escaleraalcielo/sediment_ctrl_234/Programa Windows/Codigo Fuente/SedimentTrapSoftware/AlarmaArduino/img/IMG_20160612_194149089_HDR.jpg

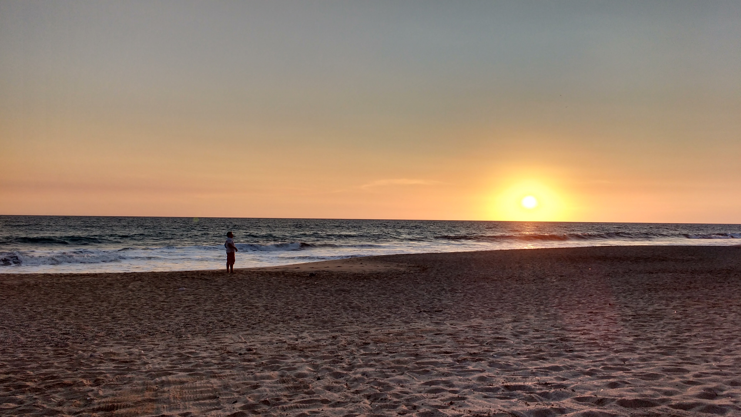
Programa Windows/Codigo Fuente/SedimentTrapSoftware/AlarmaArduino/img/IMG_20160612_194149089_HDR.jpg
