escaleraalcielo/sediment_ctrl_234/Programa Windows/Codigo Fuente/SedimentTrapSoftware/AlarmaArduino/img/Capture.PNG

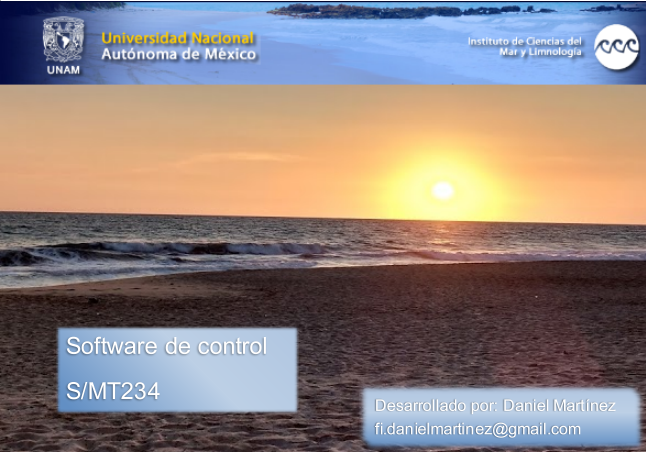
Programa Windows/Codigo Fuente/SedimentTrapSoftware/AlarmaArduino/img/Capture.PNG
