escaleraalcielo/sediment_ctrl_234/README.md

# sediment_ctrl_234
 Repositorio en Github con todo el contenido relacionado con el rediseño de la trampa de sediemntos S/MT 234
