escaleraalcielo/sediment_ctrl_234/PCB Diseño/Eagle/Circuito de Control/Sediment Board single.html

Partlist exported from C:/Users/Daniel/Documents/eagle/Sediment_Trap_Sept_2016/Sediment Board single.sch at 06/09/2016 05:12 p.m.

Part | Value | Device | Package | Description | MF | MPN | OC_FARNELL | OC_NEWARK | PROD_ID
BAT1 | CR2032 | BATTERY20PTH | BATTCOM_20MM_PTH | Battery Holders
C1 | 22pF | CNP-C025-050X025 | C025-050X025 | NON-POLARIZED CAP
C2 | 22pF | CNP-C025-050X025 | C025-050X025 | NON-POLARIZED CAP
C3 | 100nF | CNP-C025-050X025 | C025-050X025 | NON-POLARIZED CAP
C4 | 100nF | CNP-C025-050X025 | C025-050X025 | NON-POLARIZED CAP
C5 | 0.33uF | CP-TT025-040 | TT-025-040 | POLARIZED CAP
C6 | 1uF | CP-TT025-040 | TT-025-040 | POLARIZED CAP
C7 | 22uF | CNP-C025-050X025 | C025-050X025 | NON-POLARIZED CAP
D1 | 1N4004 | 1N4004 | DO41-10 | DIODE
D2 | 1N4004 | 1N4004 | DO41-10 | DIODE
D3 | 1N4947 | 1N4942 | DO41-10 | DIODE
D4 | 1N4947 | 1N4942 | DO41-10 | DIODE
D5 | 1N4947 | 1N4942 | DO41-10 | DIODE
D6 | 1N4947 | 1N4942 | DO41-10 | DIODE
D7 | 1N4004 | 1N4004 | DO41-10 | DIODE
IC1 | PCF8583P | PCF8583P | DIL08 | I2C-Bus CLOCK/CALENDAR
IC2 | ATMEGA328P | ATMEGA328PROUND | DIL28-3-ROUND | MICROCONTROLLER
J1 | Motor | M023.5MM | SCREWTERMINAL-3.5MM-2 | Standard 2-pin 0.1" header. Use with | | | | | CONN-08399
J2 | VH_Batt | M023.5MM | SCREWTERMINAL-3.5MM-2 | Standard 2-pin 0.1" header. Use with | | | | | CONN-08399
J3 | DB9_Fem | DB9FEMALE | DB9 | DB9 Connector | | | | | CONN-08194
JP1 | AVR-ISP-6 | AVR-ISP-6 | AVR-ISP-6 | AVR ISP-6 Serial Programming Header
JP3 | ENCODER | M03POLAR | MOLEX-1X3 | Header 3
MC7805CTG | +5V | V_REG_78XXSIDE | 78XXL | Voltage Regulator
Q1 | 32.768kHz | CRYSTALTC26H | TC26H | CRYSTAL | | | unknown | unknown
Q2 | 16MHz | CRYSTALHC49U70 | HC49U70 | CRYSTAL | | | unknown | unknown
R1 | 10k | R-US_0207/10 | 0207/10 | RESISTOR, American symbol
R2 | 10k | R-US_0207/10 | 0207/10 | RESISTOR, American symbol
R3 | 10k | R-US_0207/10 | 0207/10 | RESISTOR, American symbol
S1 | SW-2PTH | SWITCH-MOMENTARY-2PTH | TACTILE-PTH
U1 | L298 | L298 | MULTIWATT15 | L298 Dual Full Bridge Driver
