escaleraalcielo/sediment_ctrl_234/PCB Diseño/Eagle/Circuito de Control/GERBER/Top Silkscreen.pdf

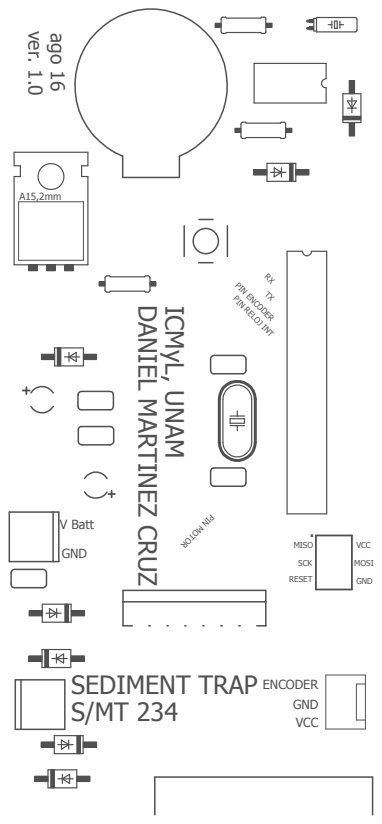
[picture p3: figure]
GND; V Batt; PIN E P NCODER IN RELOJ INT; GND VCC; ENCODER; VCC; MOSI; MISO; SCK; RESET; PIN MOTOR; SEDIMENT TRAP S/MT 234; DANIEL MARTINEZ CRUZ; ICMyL, UNAM; ver. 1.0; ago 16
