escaleraalcielo/sediment_ctrl_234/PCB Diseño/Eagle/RS233/RS233.png

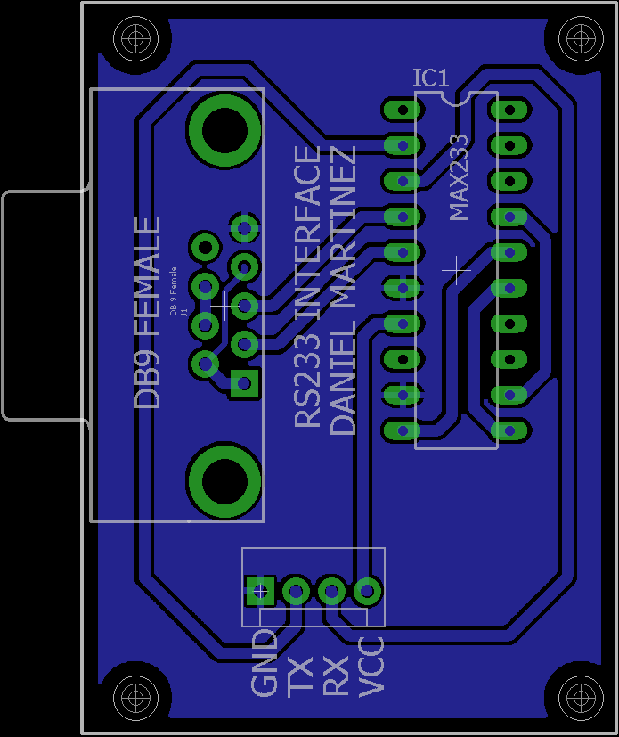
PCB Diseño/Eagle/RS233/RS233.png
