escaleraalcielo/sediment_ctrl_234/PCB Diseño/Eagle/RS233/Sediment_trap (1).png

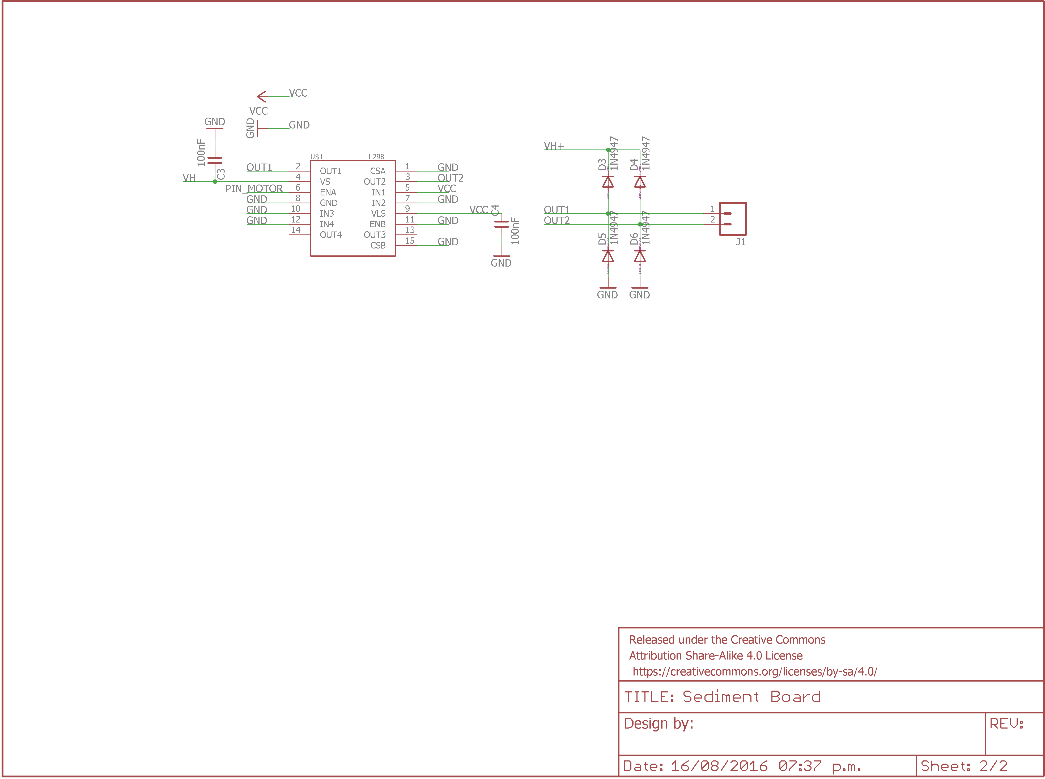
PCB Diseño/Eagle/RS233/Sediment_trap (1).png
