escaleraalcielo/sediment_ctrl_234/Programa Windows/Codigo Fuente/SedimentTrapSoftware/AlarmaArduino/img/icml.png

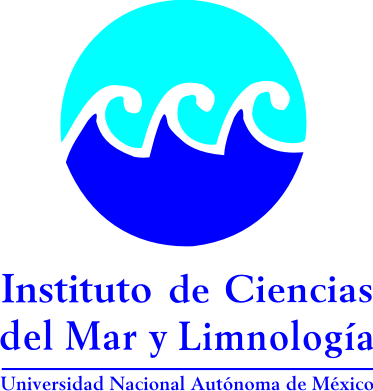
Programa Windows/Codigo Fuente/SedimentTrapSoftware/AlarmaArduino/img/icml.png
