escaleraalcielo/sediment_ctrl_234/PCB Diseño/Eagle/Circuito de Control/BOM.docx

Part | Value | Device
BAT1 | - | Base para batería
BAT1 | CR2032 | Batería CR2032
C1 | 22pF | Capacitor cerámico
C2 | 22pF | Capacitor cerámico
C3 | 100nF | Capacitor cerámico
C4 | 100nF | Capacitor cerámico
C5 | 0.33uF | Capacitor de tantalio
C6 | 1uF | Capacitor de tantalio
C7 | 22uF | Capacitor de tantalio
D1 | 1N4004 | Diodo 1N4004
D2 | 1N4004 | Diodo 1N4004
D3 | 1N4947 | Diodo recuperación rápida
D4 | 1N4947 | Diodo recuperación rápida
D5 | 1N4947 | Diodo recuperación rápida
D6 | 1N4947 | Diodo recuperación rápida
D7 | 1N4004 | Diodo 1N4004
IC1 | PCF8583P | RTC PCF8583P
IC2 | ATMEGA328P
J1 | MOLEX2 | Conector MOLEX 2 pines
J2 | MOLEX2 | Conector MOLEX 2 pines
J3 | DB9_Fem | Conector DB9 Hembra
JP1 | AVR-ISP-6 | Jumper 2 x 3
JP3 | MOLEX3 | Conector MOLEX 3 pines
MC7805CTG | +5V | Regulador de 5V
Q1 | 32.768kHz | CRISTAL 32.768kHz
Q2 | 16MHz | CRISTAL 16MHz
R1 | 10k | Resistencia
R2 | 10k | Resistencia
R3 | 10k | Resistencia
S1 | SW-2PTH | Push Button-2PTH
U1 | L298 | L298
