escaleraalcielo/sediment_ctrl_234/Programa Windows/Codigo Fuente/SedimentTrapSoftware/AlarmaArduino/bin/Debug/test.txt

Fechas de control de la trampa de sedimentos

Instituto de Ciencias del Mar y Limnologia, UNAM

Fecha de creacion del archivo: 
30/08/2016 04:34:57 p.m.

Lista de fechas programadas en la trampa de sedimentos
1) 01/09/2016
2) 15/09/2016
3) 01/10/2016
