escaleraalcielo/sediment_ctrl_234/PCB Diseño/Eagle/RS233/RS233_BRD.pdf

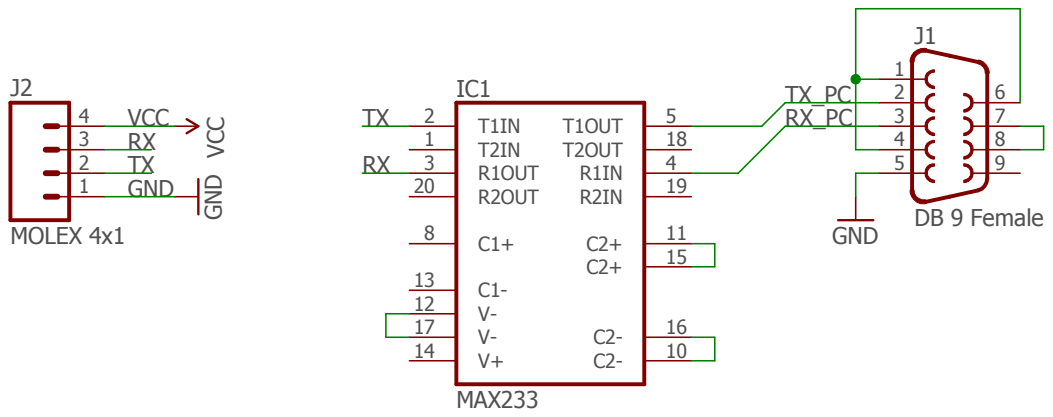
[picture p9: page 1]
MAX233; DB 9 Female; MOLEX 4x1; VCC GND; GND; T1IN 2 T2IN 1 R1OUT 3 R2OUT 20; T1OUT; T2OUT; VCC; Design by:

Released under the Creative Commons
Attribution Share-Alike 4.0 License
https://creativecommons.org/licenses/by-sa/4.0/

11/08/2016 09:38 p.m. C:\Users\Daniel\Documents\eagle\RS233\RS233_BRD.sch (Sheet: 1/1)
