escaleraalcielo/sediment_ctrl_234/PCB Diseño/Eagle/RS233/RS233_BRD_PCB.pdf

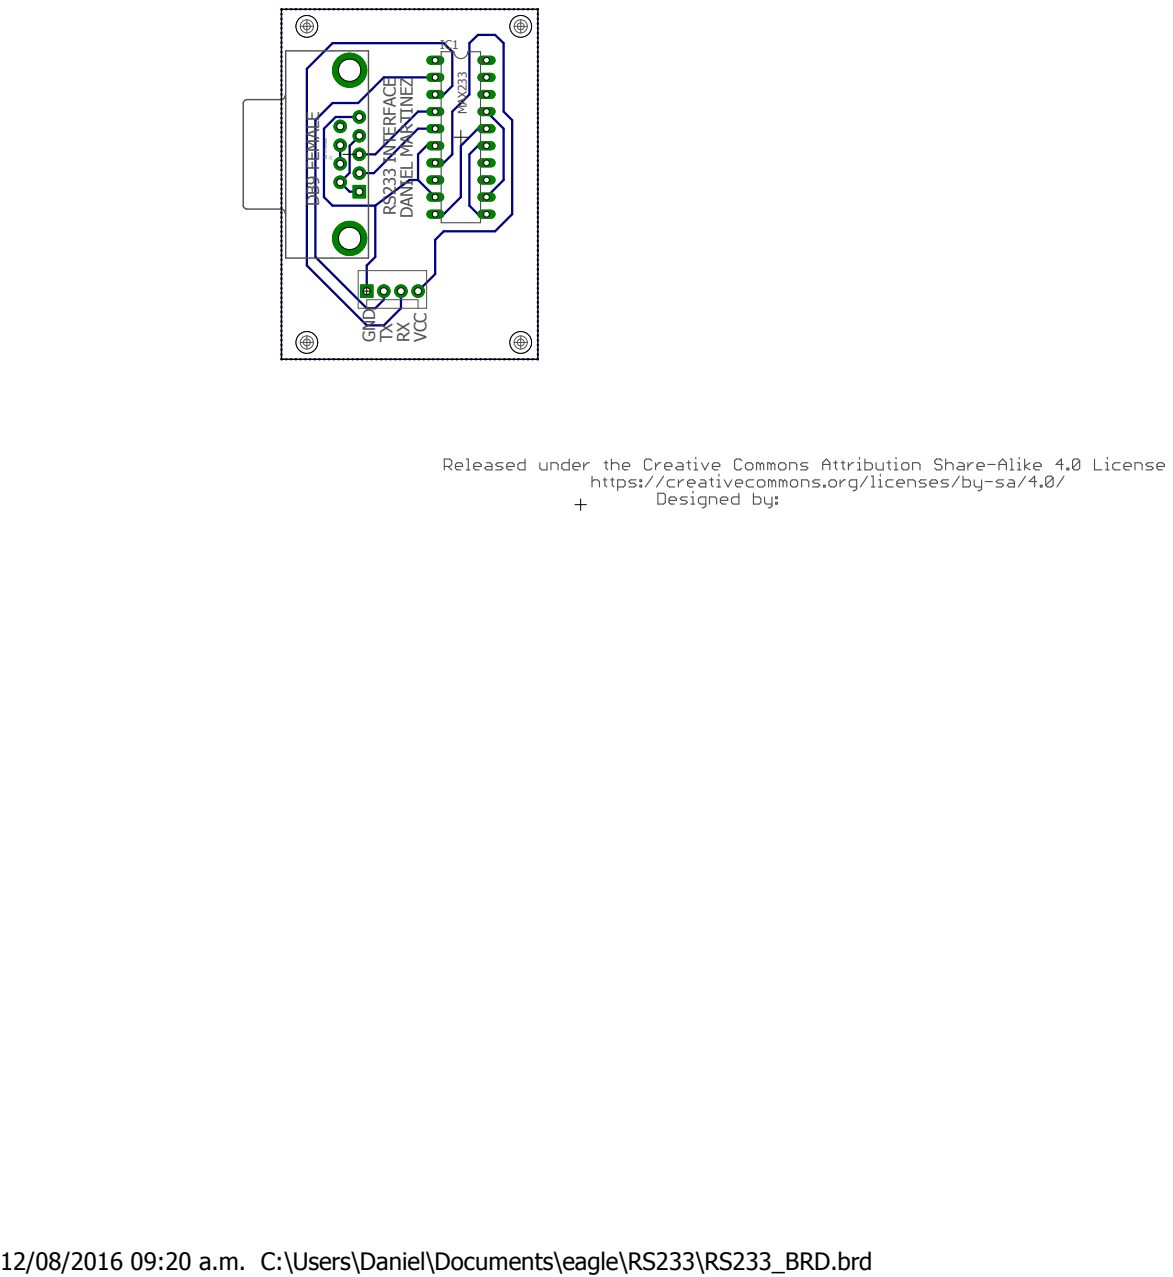
[picture p10: page 1]
12/08/2016 09:20 a.m. C:\Users\Daniel\Documents\eagle\RS233\RS233_BRD.brd GND TXRXVCC DB9 FEMALE; RS233 INTERFACE DANIEL MARTINEZ; MAX233; DB 9 Female
