escaleraalcielo/sediment_ctrl_234/PCB Diseño/Eagle/Circuito de Control/GERBER/Bottom Copper.pdf

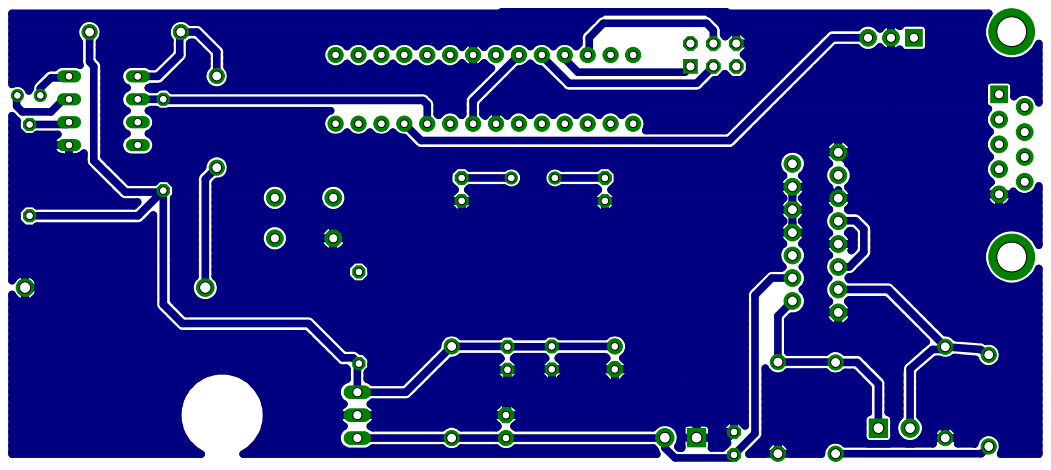
[picture p11: page 1]
