escaleraalcielo/sediment_ctrl_234/PCB Diseño/Eagle/Circuito de Control/GERBER/bottom soldermask.pdf

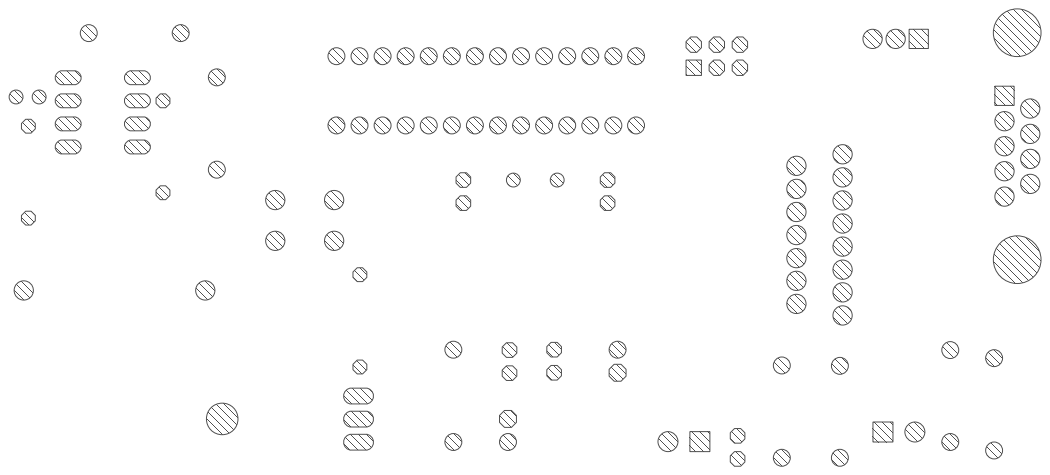
[picture p12: page 1]
