escaleraalcielo/sediment_ctrl_234/PCB Diseño/Eagle/Circuito de Control/GERBER/Drill File.pdf

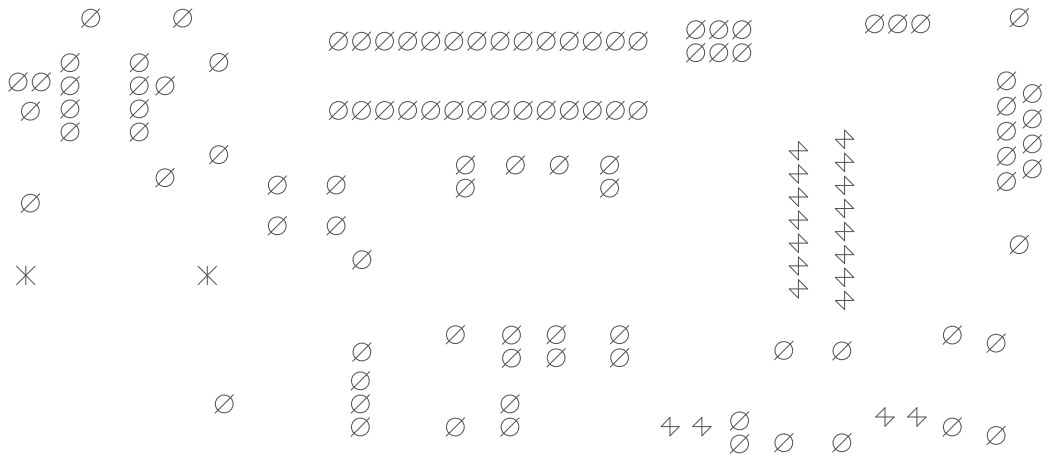
[picture p13: page 1]
