escaleraalcielo/sediment_ctrl_234/PCB Diseño/Eagle/Circuito de Control/GERBER/Top Copper.pdf

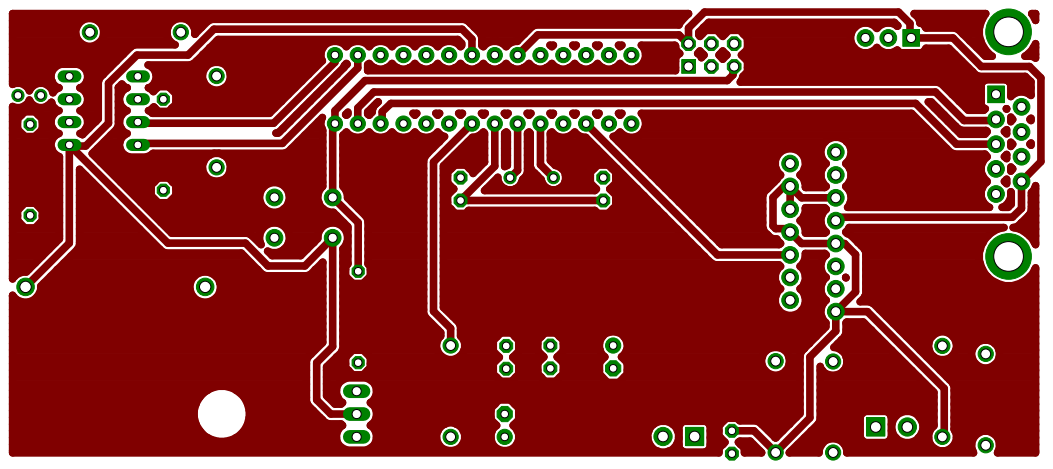
[picture p14: page 1]
