escaleraalcielo/sediment_ctrl_234/PCB Diseño/Eagle/Circuito de Control/GERBER/top soldermask.pdf

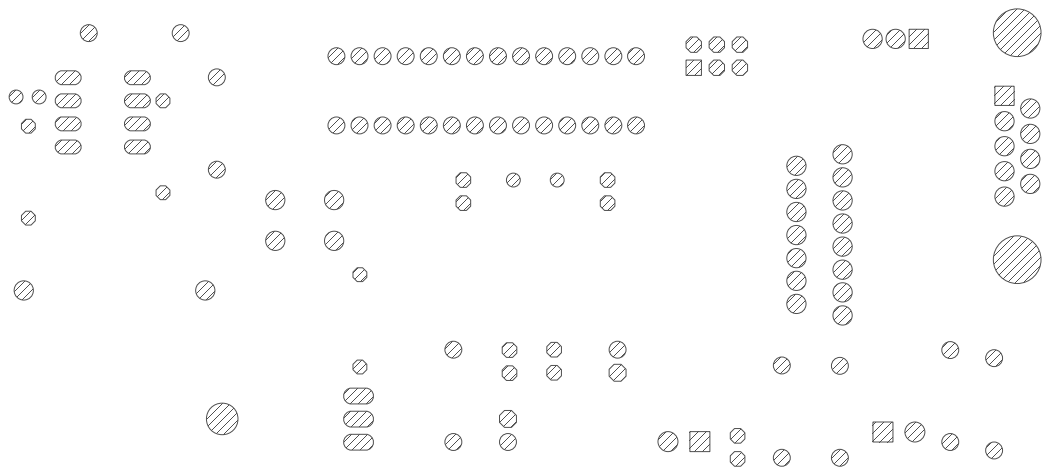
[picture p15: page 1]
