escaleraalcielo/sediment_ctrl_234/PCB Diseño/Eagle/Circuito de Control/Sediment Board.brd

## EAGLE design PCB Diseño/Eagle/Circuito de Control/Sediment Board.brd (2016-09-06)

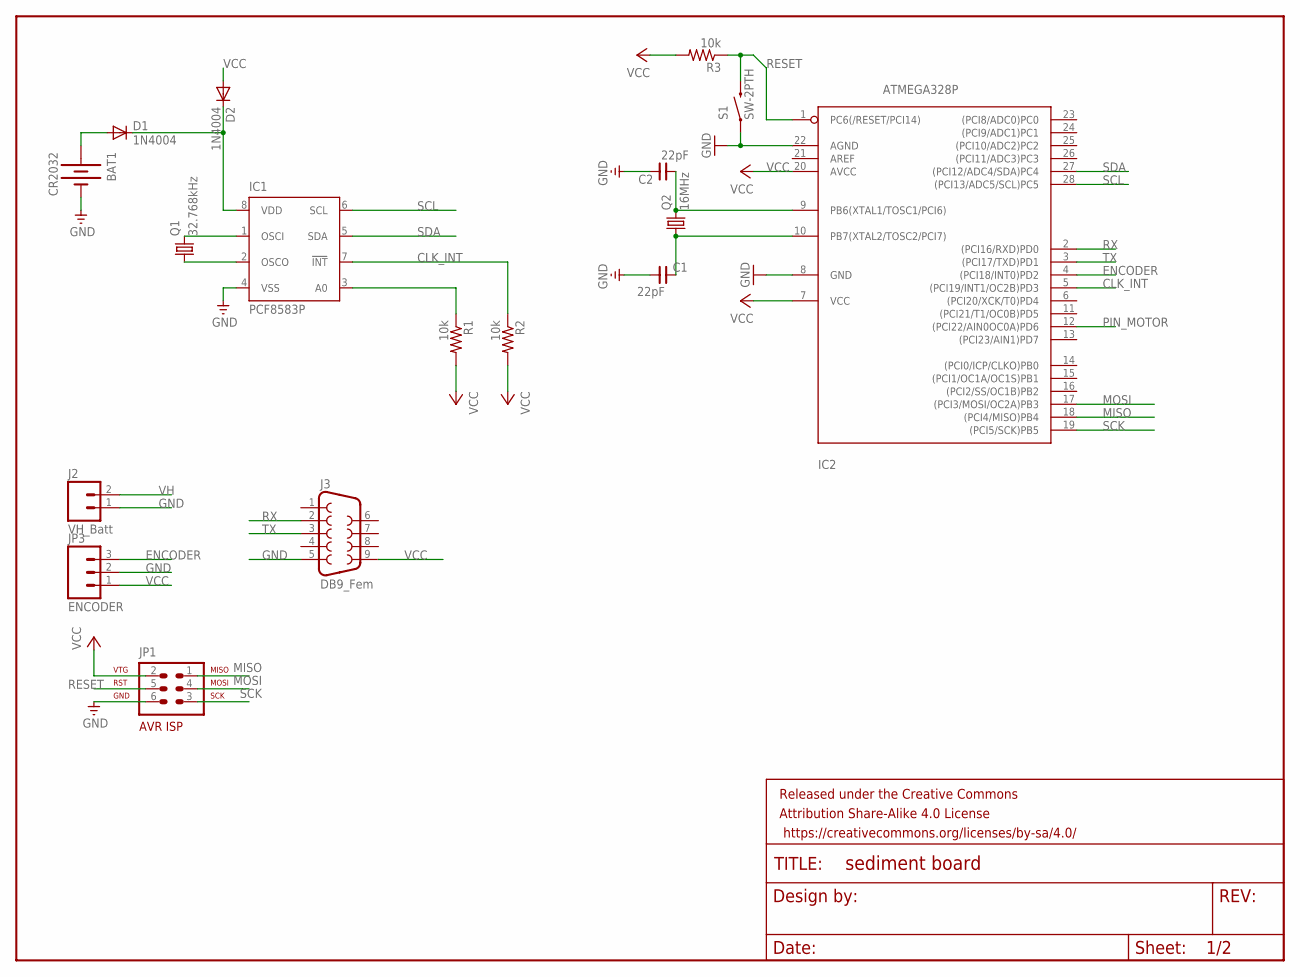
[picture p16: schematic Sediment Board.sch, sheet 1]

Parts:
BAT1: CR2032; BATTCOM_20MM_PTH
C1, C2: 22pF; C025-050X025
D1, D2: 1N4004; DO41-10
FRAME1: FRAME-LETTER; CREATIVE_COMMONS
IC1: PCF8583P; DIL08
IC2: ATMEGA328P; DIL28-3-ROUND
J2: VH_Batt; SCREWTERMINAL-3.5MM-2
J3: DB9_Fem; DB9
JP1: AVR-ISP-6
JP3: ENCODER; MOLEX-1X3
Q1: 32.768kHz; TC26H
Q2: 16MHz; HC49U70
R1, R2, R3: 10k; 0207/10
S1: SW-2PTH; TACTILE-PTH

Connections:
CLK_INT: IC1.7 (!INT), IC2.5 ((PCI19/INT1/OC2B)PD3), R2.1
ENCODER: IC2.4 ((PCI18/INT0)PD2), JP3.3
GND: BAT1.2 (-), C1.1, C2.2, IC1.4 (VSS), IC2.8 (GND), IC2.22 (AGND), J2.1, J3.5, JP1.6, JP3.2, S1.1; also elsewhere on the board
MISO: IC2.18 ((PCI4/MISO)PB4), JP1.1
MOSI: IC2.17 ((PCI3/MOSI/OC2A)PB3), JP1.4
unnamed: D1.C, D2.C, IC1.8 (VDD)
unnamed: IC1.1 (OSCI), Q1.2
unnamed: IC1.2 (OSCO), Q1.1
unnamed: BAT1.1 (+), D1.A
unnamed: IC1.3 (A0), R1.1
unnamed: C2.1, IC2.9 (PB6(XTAL1/TOSC1/PCI6)), Q2.2
unnamed: C1.2, IC2.10 (PB7(XTAL2/TOSC2/PCI7)), Q2.1
PIN_MOTOR: IC2.12 ((PCI22/AIN0OC0A)PD6); also elsewhere on the board
RESET: IC2.1 (PC6(/RESET/PCI14)), JP1.5, R3.1, S1.3 (2)
RX: IC2.2 ((PCI16/RXD)PD0), J3.2
SCK: IC2.19 ((PCI5/SCK)PB5), JP1.3
SCL: IC1.6 (SCL), IC2.28 ((PCI13/ADC5/SCL)PC5)
SDA: IC1.5 (SDA), IC2.27 ((PCI12/ADC4/SDA)PC4)
TX: IC2.3 ((PCI17/TXD)PD1), J3.3
VCC: D2.A, IC2.7 (VCC), IC2.20 (AVCC), J3.9, JP1.2, JP3.1, R1.2, R2.2, R3.2; also elsewhere on the board
VH: J2.2; also elsewhere on the board

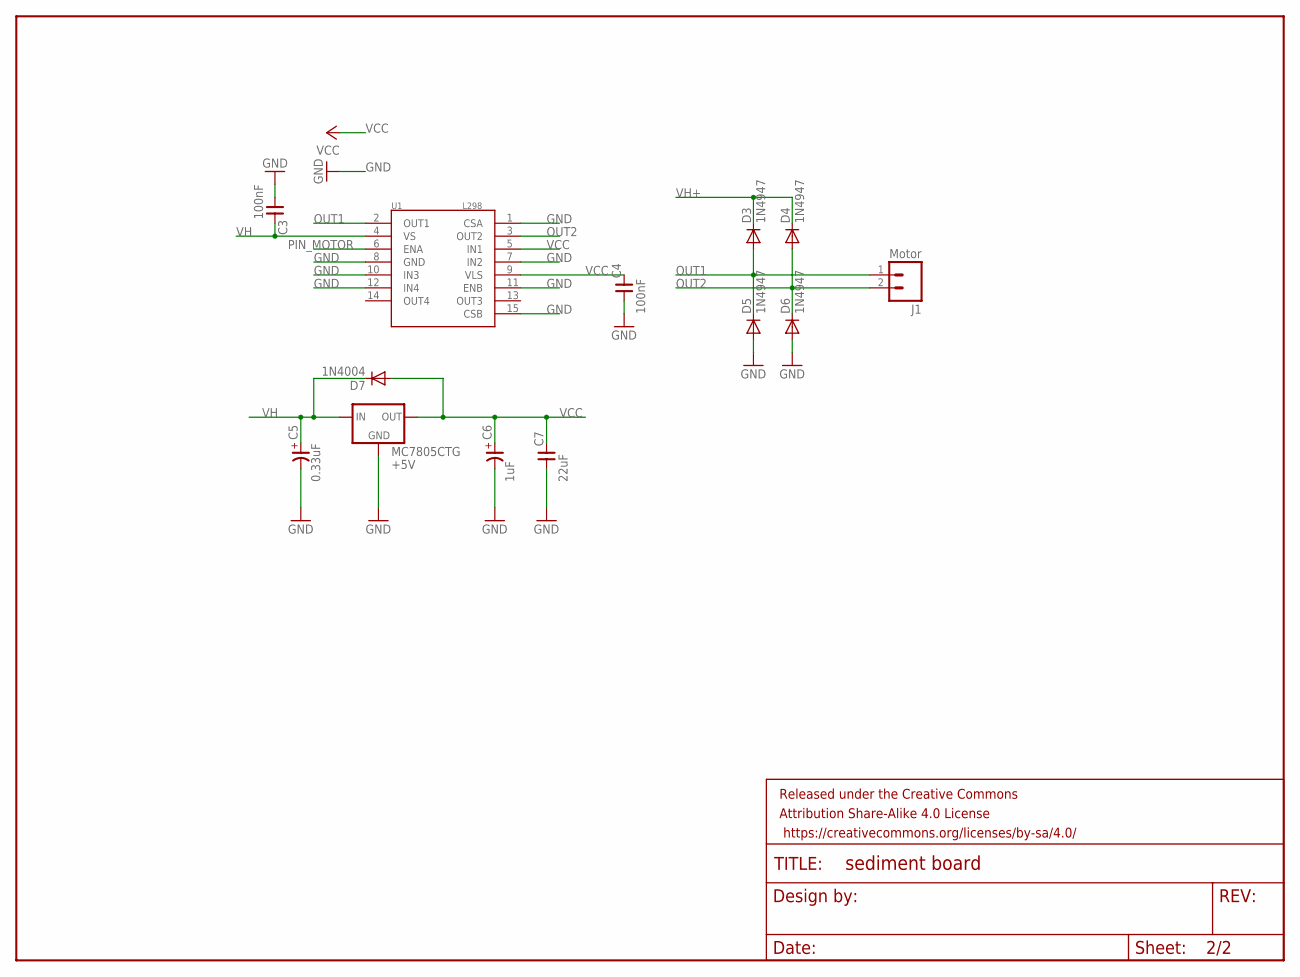
[picture p17: schematic Sediment Board.sch, sheet 2]

Parts:
C3, C4: 100nF; C025-050X025
C5: 0.33uF; TT-025-040
C6: 1uF; TT-025-040
C7: 22uF; C025-050X025
D3, D4, D5, D6: 1N4947; DO41-10
D7: 1N4004; DO41-10
FRAME2: FRAME-LETTER; CREATIVE_COMMONS
J1: Motor; SCREWTERMINAL-3.5MM-2
MC7805CTG: +5V; 78XXL
U1: L298; MULTIWATT15

Connections:
GND: C3.1, C4.1, C5.-, C6.-, C7.1, D5.A, D6.A, MC7805CTG.GND, U1.1 (CSA), U1.7 (IN2), U1.8 (GND), U1.10 (IN3), U1.11 (ENB), U1.12 (IN4), U1.15 (CSB); also elsewhere on the board
OUT1: D3.A, D5.C, J1.1, U1.2 (OUT1)
OUT2: D4.A, D6.C, J1.2, U1.3 (OUT2)
PIN_MOTOR: U1.6 (ENA); also elsewhere on the board
VCC: C4.2, C6.+, C7.2, D7.A, MC7805CTG.OUT, U1.5 (IN1), U1.9 (VLS); also elsewhere on the board
VH: C3.2, C5.+, D7.C, MC7805CTG.IN, U1.4 (VS); also elsewhere on the board
VH+: D3.C, D4.C

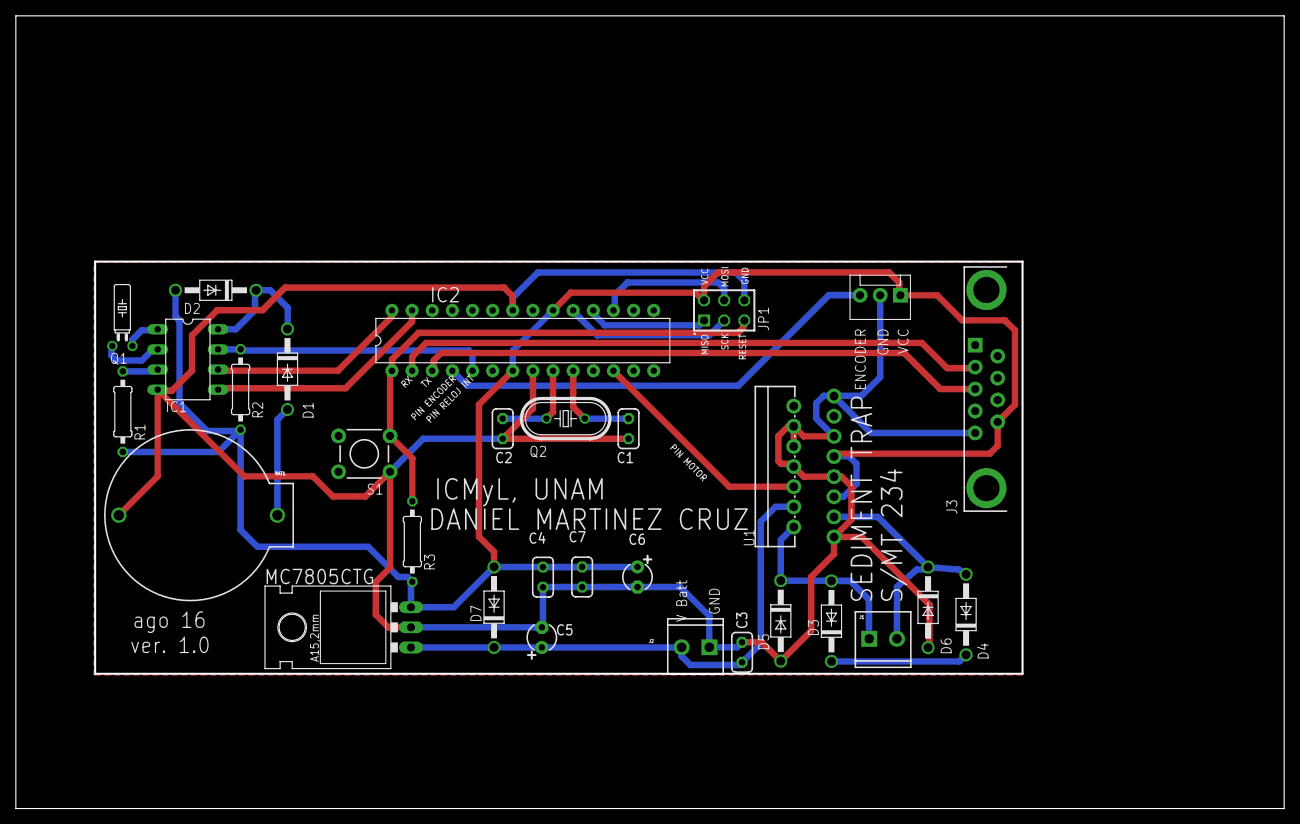
[picture p18: board Sediment Board.brd from above]

Board: 2 copper layers, 160.0 x 100.0 mm, 32 parts (0 on the bottom side), 24 nets.
