escaleraalcielo/sediment_ctrl_234/PCB Diseño/Eagle/RS233/RS233_BRD_single.brd

## EAGLE design PCB Diseño/Eagle/RS233/RS233_BRD_single.brd (2016-09-06)

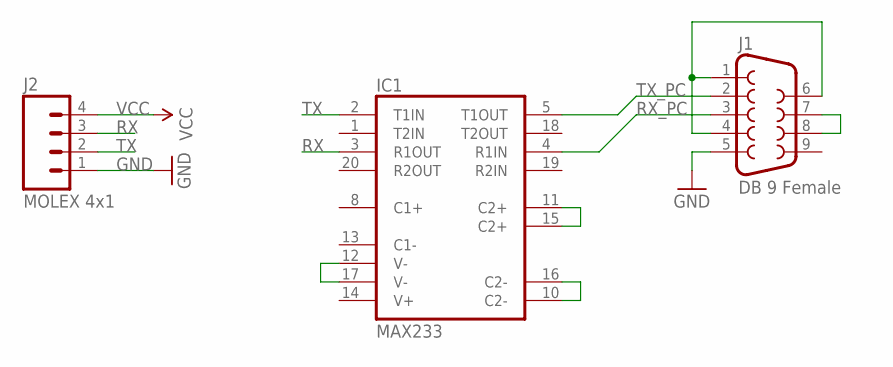
[picture p19: schematic RS233_BRD_single.sch]

Parts:
IC1: MAX233; DIL20
J1: DB 9 Female; DB9
J2: MOLEX 4x1; MOLEX-1X4

Connections:
GND: IC1.6 (GND), IC1.9 (GND), J1.5, J2.1
unnamed: IC1.11 (C2+), IC1.15 (C2+)
unnamed: IC1.10 (C2-), IC1.16 (C2-)
unnamed: J1.7, J1.8
unnamed: J1.1, J1.4, J1.6
unnamed: IC1.12 (V-), IC1.17 (V-)
RX: IC1.3 (R1OUT), J2.3
RX_PC: IC1.4 (R1IN), J1.3
TX: IC1.2 (T1IN), J2.2
TX_PC: IC1.5 (T1OUT), J1.2
VCC: IC1.7 (VCC), J2.4

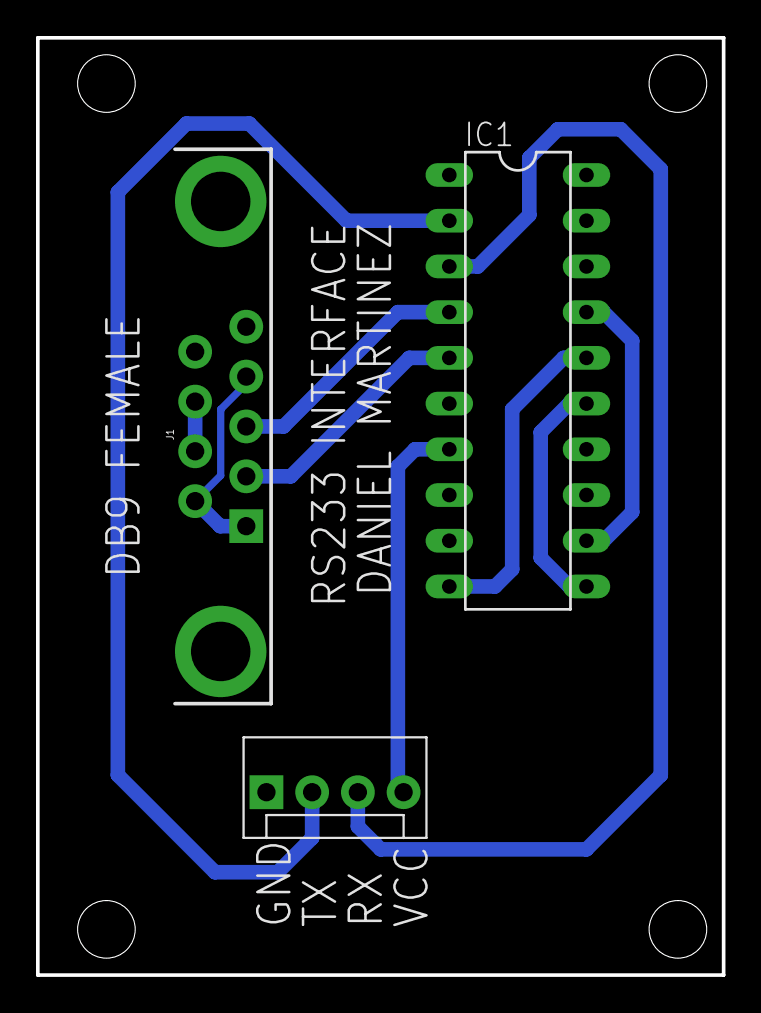
[picture p20: board RS233_BRD_single.brd from above]

Board: 2 copper layers, 38.1 x 52.1 mm, 3 parts (0 on the bottom side), 11 nets.
