escaleraalcielo/sediment_ctrl_234/(commit log)

2016-09-06 Archivos de PCB
    [RS233_BRD.brd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]
2016-09-06 Archivos GERBER generados correctamente
    [Sediment Board single.sch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]
2016-09-10 Eliminación para actualizar archivos
    Nuevos archivos generados
    [Sediment Board single.brd, Sediment Board single.sch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]
2016-09-10 actualización al 9 de septiembre
    [Bottom Copper.GBL, Bottom Soldermask.GBS, RS233_BRD.GBL, RS233_BRD.GBO, RS233_BRD.GBS, RS233_BRD.GTL, RS233_BRD.GTO, RS233_BRD.GTP]
2016-10-05 edited to 2016_10_05
    [AlarmaArduino.sdf]
