escaleraalcielo/sediment_ctrl_234/(notices)

Notices in the files:
Programa Microcontrolador/Arduino/librerías/RTC_PCF8583P/Rtc_Pcf8583P.cpp:
This program is free software; you can redistribute it and/or modify
it under the terms of the GNU General Public License as published by
the Free Software Foundation; either version 2 of the License, or
(at your option) any later version.
parts and their libraries:
SparkFun-Aesthetics: Licensing: Creative Commons ShareAlike 4.0 International - https://creativecommons.org/licenses/by-sa/4.0
supply0: Copyright (C) 2007, Bob Starr
